calebe-sucupira/can-busoff-mitigation/experiments/busoff/plano_campanha_phase20_40_runs.csv

run_previsto | perfil | intervalo_min_us | intervalo_max_us | seed_hex | duracao_injecao_s | condicao | throttling_esperado | bloco | pulsos_ideais_previstos
304 | PHASE20 | 20000 | 20000 | 0x6D2B79F5 | 40 | ADAPTATIVO | 1 | 1 | 1999
305 | PHASE20 | 20000 | 20000 | 0x6D2B79F5 | 40 | ADAPTATIVO | 1 | 1 | 1999
306 | PHASE20 | 20000 | 20000 | 0x6D2B79F5 | 40 | ADAPTATIVO | 1 | 1 | 1999
307 | PHASE20 | 20000 | 20000 | 0x6D2B79F5 | 40 | ADAPTATIVO | 1 | 1 | 1999
308 | PHASE20 | 20000 | 20000 | 0x6D2B79F5 | 40 | ADAPTATIVO | 1 | 1 | 1999
309 | PHASE20 | 20000 | 20000 | 0x6D2B79F5 | 40 | REFERENCIA | 0 | 2 | 1999
310 | PHASE20 | 20000 | 20000 | 0x6D2B79F5 | 40 | REFERENCIA | 0 | 2 | 1999
311 | PHASE20 | 20000 | 20000 | 0x6D2B79F5 | 40 | REFERENCIA | 0 | 2 | 1999
312 | PHASE20 | 20000 | 20000 | 0x6D2B79F5 | 40 | REFERENCIA | 0 | 2 | 1999
313 | PHASE20 | 20000 | 20000 | 0x6D2B79F5 | 40 | REFERENCIA | 0 | 2 | 1999
314 | PHASE20 | 20000 | 20000 | 0x6D2B79F5 | 40 | ADAPTATIVO | 1 | 3 | 1999
315 | PHASE20 | 20000 | 20000 | 0x6D2B79F5 | 40 | ADAPTATIVO | 1 | 3 | 1999
316 | PHASE20 | 20000 | 20000 | 0x6D2B79F5 | 40 | ADAPTATIVO | 1 | 3 | 1999
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
