calebe-sucupira/can-busoff-mitigation/experiments/characterization/complementary/plano_24_ensaios.csv

run_previsto | bloco | condicao | throttling_esperado | perfil | intervalo_min_us | intervalo_max_us | seed_hex | duracao_injecao_s | pulsos_ideais_previstos | natureza
197 | 7 | REFERENCIA | 0 | BAIXO | 40000 | 60000 | 0xD820CD8A | 40 | 799 | AMPLIACAO_PREDEFINIDA_10_REPETICOES
198 | 7 | REFERENCIA | 0 | MEDIO_V2 | 17500 | 22500 | 0xD820CD8A | 40 | 2002 | AMPLIACAO_PREDEFINIDA_10_REPETICOES
199 | 7 | REFERENCIA | 0 | ALTO | 9375 | 14375 | 0xD820CD8A | 40 | 3376 | AMPLIACAO_PREDEFINIDA_10_REPETICOES
200 | 7 | ADAPTATIVO | 1 | ALTO | 9375 | 14375 | 0xD820CD8A | 40 | 3376 | AMPLIACAO_PREDEFINIDA_10_REPETICOES
201 | 7 | ADAPTATIVO | 1 | MEDIO_V2 | 17500 | 22500 | 0xD820CD8A | 40 | 2002 | AMPLIACAO_PREDEFINIDA_10_REPETICOES
202 | 7 | ADAPTATIVO | 1 | BAIXO | 40000 | 60000 | 0xD820CD8A | 40 | 799 | AMPLIACAO_PREDEFINIDA_10_REPETICOES
203 | 8 | ADAPTATIVO | 1 | MEDIO_V2 | 17500 | 22500 | 0x1E3D31CA | 40 | 2000 | AMPLIACAO_PREDEFINIDA_10_REPETICOES
204 | 8 | ADAPTATIVO | 1 | ALTO | 9375 | 14375 | 0x1E3D31CA | 40 | 3369 | AMPLIACAO_PREDEFINIDA_10_REPETICOES
205 | 8 | ADAPTATIVO | 1 | BAIXO | 40000 | 60000 | 0x1E3D31CA | 40 | 800 | AMPLIACAO_PREDEFINIDA_10_REPETICOES
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
