calebe-sucupira/can-busoff-mitigation/experiments/characterization/initial/plano_36_ensaios.csv

run_previsto | bloco | condicao | throttling_esperado | perfil | intervalo_min_us | intervalo_max_us | seed_hex | duracao_injecao_s | pulsos_ideais_previstos | natureza
153 | 1 | REFERENCIA | 0 | BAIXO | 40000 | 60000 | 0xEA125C50 | 40 | 804 | OFICIAL
154 | 1 | REFERENCIA | 0 | MEDIO_V2 | 17500 | 22500 | 0xEA125C50 | 40 | 1999 | OFICIAL
155 | 1 | REFERENCIA | 0 | ALTO | 9375 | 14375 | 0xEA125C50 | 40 | 3361 | OFICIAL
156 | 1 | ADAPTATIVO | 1 | ALTO | 9375 | 14375 | 0xEA125C50 | 40 | 3361 | OFICIAL
157 | 1 | ADAPTATIVO | 1 | MEDIO_V2 | 17500 | 22500 | 0xEA125C50 | 40 | 1999 | OFICIAL
158 | 1 | ADAPTATIVO | 1 | BAIXO | 40000 | 60000 | 0xEA125C50 | 40 | 804 | OFICIAL
159 | 2 | ADAPTATIVO | 1 | MEDIO_V2 | 17500 | 22500 | 0x361424B1 | 40 | 2004 | OFICIAL
160 | 2 | ADAPTATIVO | 1 | ALTO | 9375 | 14375 | 0x361424B1 | 40 | 3371 | OFICIAL
161 | 2 | ADAPTATIVO | 1 | BAIXO | 40000 | 60000 | 0x361424B1 | 40 | 800 | OFICIAL
162 | 2 | REFERENCIA | 0 | BAIXO | 40000 | 60000 | 0x361424B1 | 40 | 800 | OFICIAL
163 | 2 | REFERENCIA | 0 | ALTO | 9375 | 14375 | 0x361424B1 | 40 | 3371 | OFICIAL
164 | 2 | REFERENCIA | 0 | MEDIO_V2 | 17500 | 22500 | 0x361424B1 | 40 | 2004 | OFICIAL
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
