calebe-sucupira/can-busoff-mitigation/hardware/can-injector-board/can-injector-board.kicad_pcb

## KiCad design hardware/can-injector-board/can-injector-board.kicad_pcb (2026-10-07)

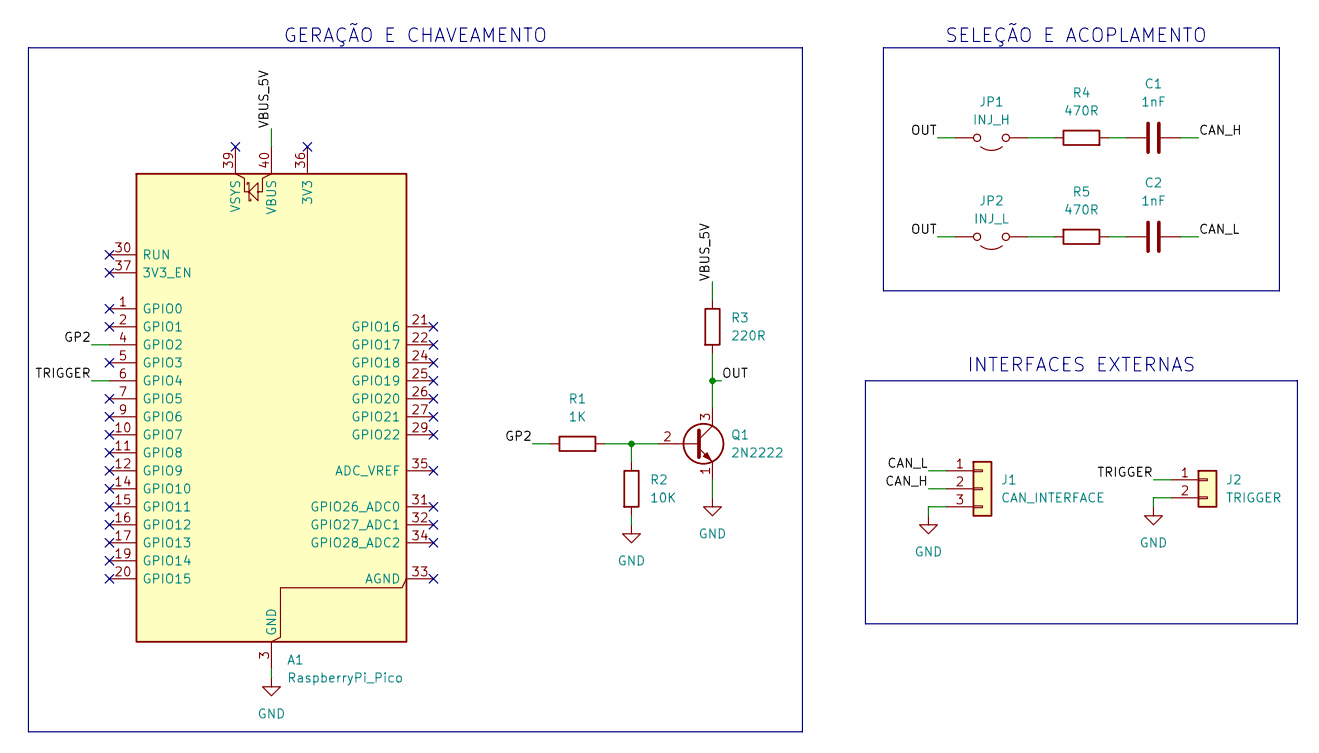
[picture p1: schematic can-injector-board.kicad_sch, CAN Perturbation Injector]

Parts:
A1: RaspberryPi_Pico; RaspberryPi_Pico_Common_THT_Manual
C1, C2: 1nF; C_Disc_D5.0mm_W2.5mm_P5.00mm_Manual
J1: CAN_INTERFACE; PinHeader_1x03_P2.54mm_Vertical_Manual
J2: TRIGGER; PinHeader_1x02_P2.54mm_Vertical_Manual
JP1: INJ_H; PinHeader_1x02_P2.54mm_Vertical_Manual
JP2: INJ_L; PinHeader_1x02_P2.54mm_Vertical_Manual
Q1: 2N2222; TO-92_Inline_Wide_Manual
R1: 1K; R_Axial_DIN0207_L6.3mm_D2.5mm_P7.62mm_Horizontal_Manual
R2: 10K; R_Axial_DIN0207_L6.3mm_D2.5mm_P7.62mm_Horizontal_Manual
R3: 220R; R_Axial_DIN0207_L6.3mm_D2.5mm_P7.62mm_Horizontal_Manual
R4, R5: 470R; R_Axial_DIN0207_L6.3mm_D2.5mm_P7.62mm_Horizontal_Manual

Connections:
/CAN_H: C1.2, J1.2
/CAN_L: C2.2, J1.1
/GP2: A1.4 (GPIO2), R1.1
/OUT: JP1.2 (B), JP2.2 (B), Q1.3 (C), R3.2
/TRIGGER: A1.6 (GPIO4), J2.1
/VBUS_5V: A1.40 (VBUS), R3.1
GND: A1.3 (GND), A1.8 (GND), A1.13 (GND), A1.18 (GND), A1.23 (GND), A1.28 (GND), A1.38 (GND), J1.3, J2.2, Q1.1 (E), R2.2
unnamed: C1.1, R4.2
unnamed: C2.1, R5.1
unnamed: JP1.1 (A), R4.1
unnamed: JP2.1 (A), R5.2
unnamed: Q1.2 (B), R1.2, R2.1

Notes on the sheet:
GERAÇÃO E CHAVEAMENTO
INTERFACES EXTERNAS
SELEÇÃO E ACOPLAMENTO

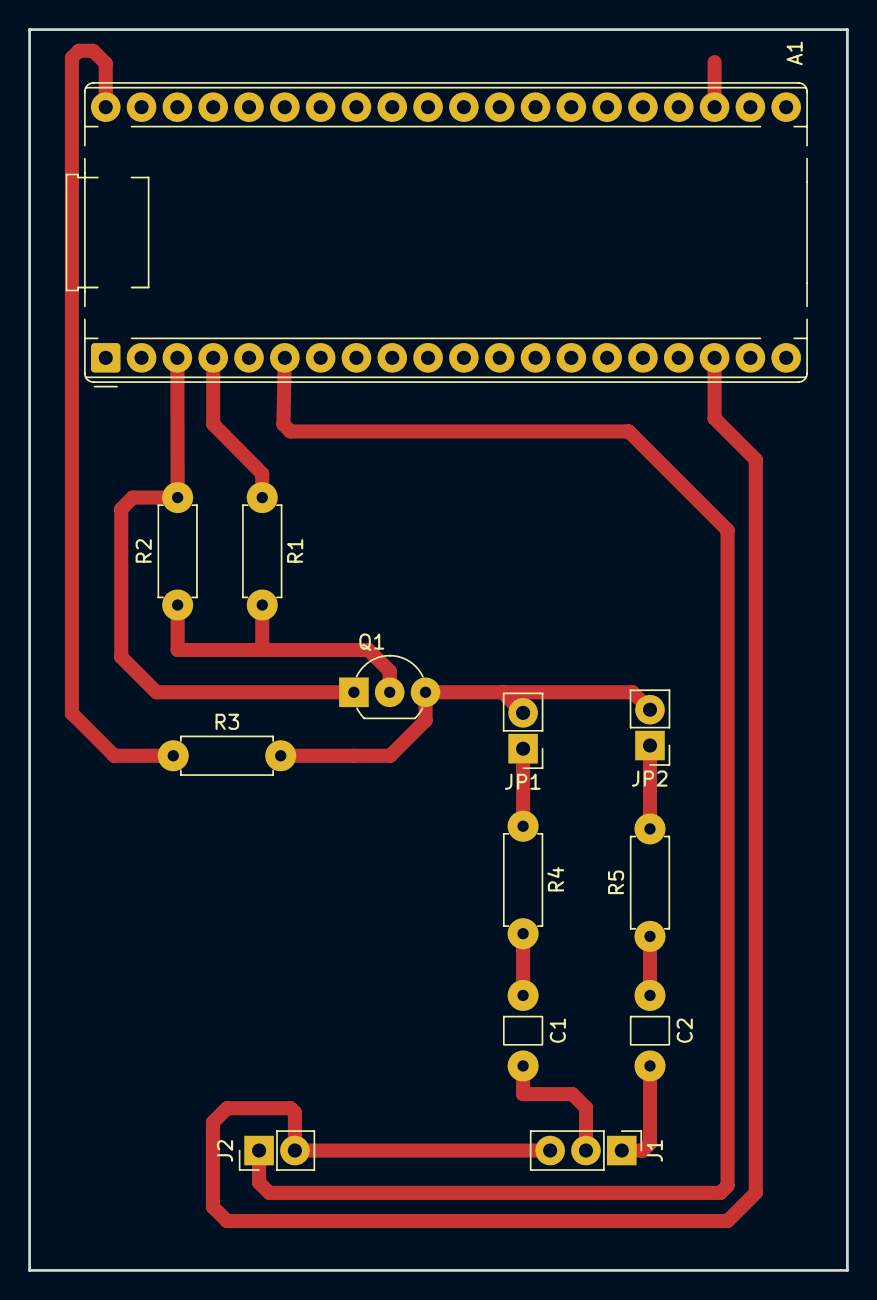
[picture p2: board can-injector-board.kicad_pcb from above]

Board: 2 copper layers, 58.0 x 88.0 mm, 13 parts (0 on the bottom side), 12 nets.
