calebe-sucupira/can-busoff-mitigation/hardware/can-experiment-board/can-experiment-board.kicad_pcb

## KiCad design hardware/can-experiment-board/can-experiment-board.kicad_pcb (2026-10-07)

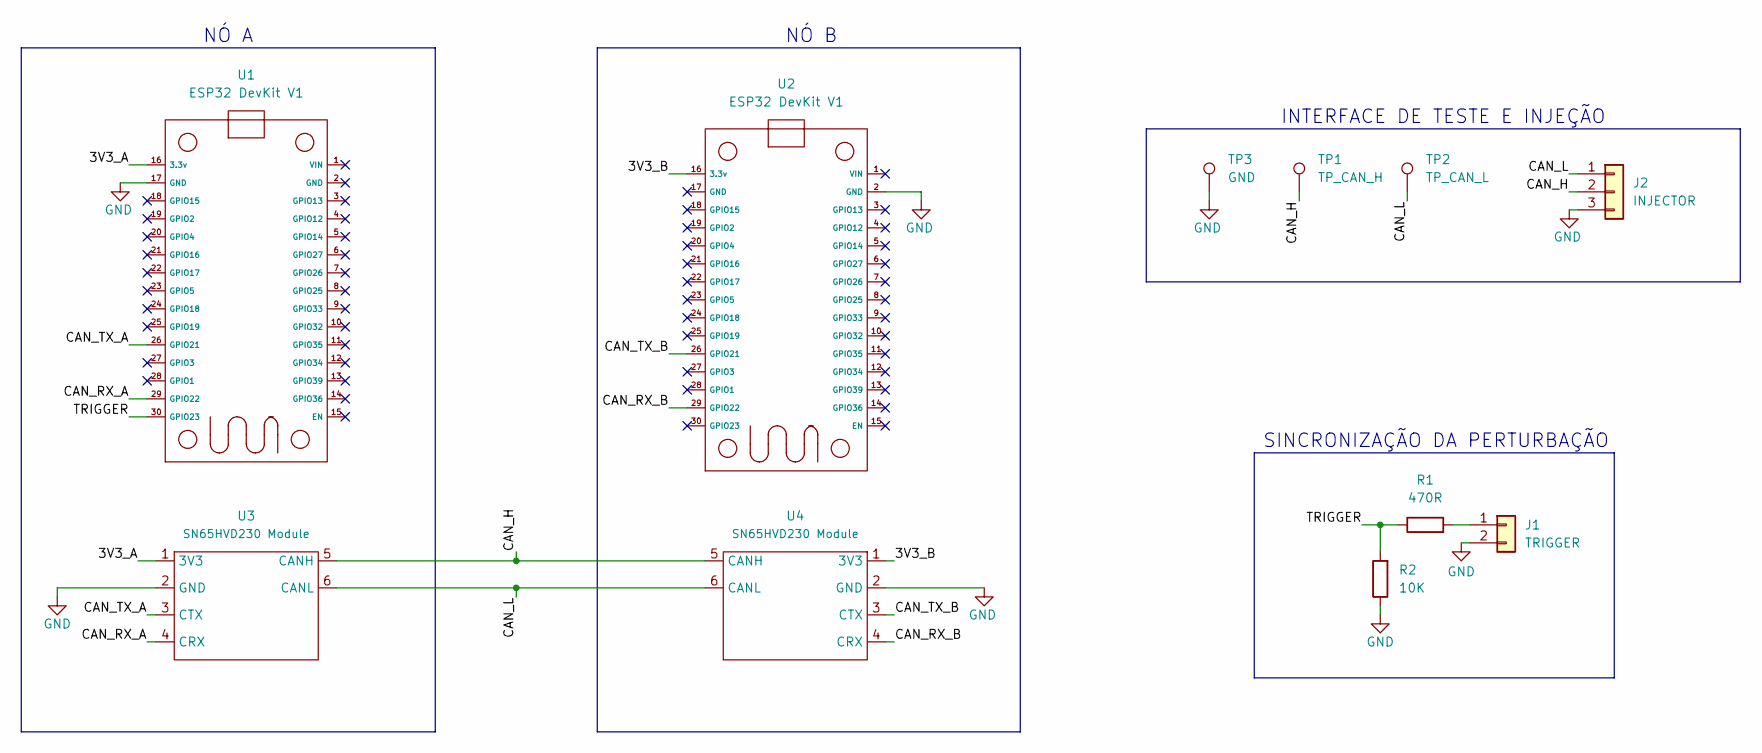
[picture p3: schematic can-experiment-board.kicad_sch, CAN Experiment Board]

Parts:
J1: TRIGGER; PinHeader_1x02_P2.54mm_Vertical_Manual
J2: INJECTOR; PinHeader_1x03_P2.54mm_Vertical_Manual
R1: 470R; R_Axial_DIN0207_L6.3mm_D2.5mm_P7.62mm_Horizontal_Manual
R2: 10K; R_Axial_DIN0207_L6.3mm_D2.5mm_P7.62mm_Horizontal_Manual
TP1: TP_CAN_H; TestPoint_THTPad_D2.5mm_Drill1.2mm
TP2: TP_CAN_L; TestPoint_THTPad_D2.5mm_Drill1.2mm
TP3: GND; TestPoint_THTPad_D2.5mm_Drill1.2mm
U1, U2: ESP32 DevKit V1; ESP32_30pin_Manual
U3, U4: SN65HVD230 Module; SN65HVD230_Module_1x06_Manual

Connections:
/3V3_A: U1.16 (3.3v), U3.1 (3V3)
/3V3_B: U2.16 (3.3v), U4.1 (3V3)
/CAN_H: J2.2, TP1.1 (1_1), U3.5 (CANH), U4.5 (CANH)
/CAN_L: J2.1, TP2.1 (1_1), U3.6 (CANL), U4.6 (CANL)
/CAN_RX_A: U1.29 (GPIO22), U3.4 (CRX)
/CAN_RX_B: U2.29 (GPIO22), U4.4 (CRX)
/CAN_TX_A: U1.26 (GPIO21), U3.3 (CTX)
/CAN_TX_B: U2.26 (GPIO21), U4.3 (CTX)
/TRIGGER: R1.1, R2.2, U1.30 (GPIO23)
GND: J1.2, J2.3, R2.1, TP3.1 (1_1), U1.17 (GND), U2.2 (GND), U3.2 (GND), U4.2 (GND)
unnamed: J1.1, R1.2

Notes on the sheet:
NÓ A
NÓ B
SINCRONIZAÇÃO DA PERTURBAÇÃO
INTERFACE DE TESTE E INJEÇÃO

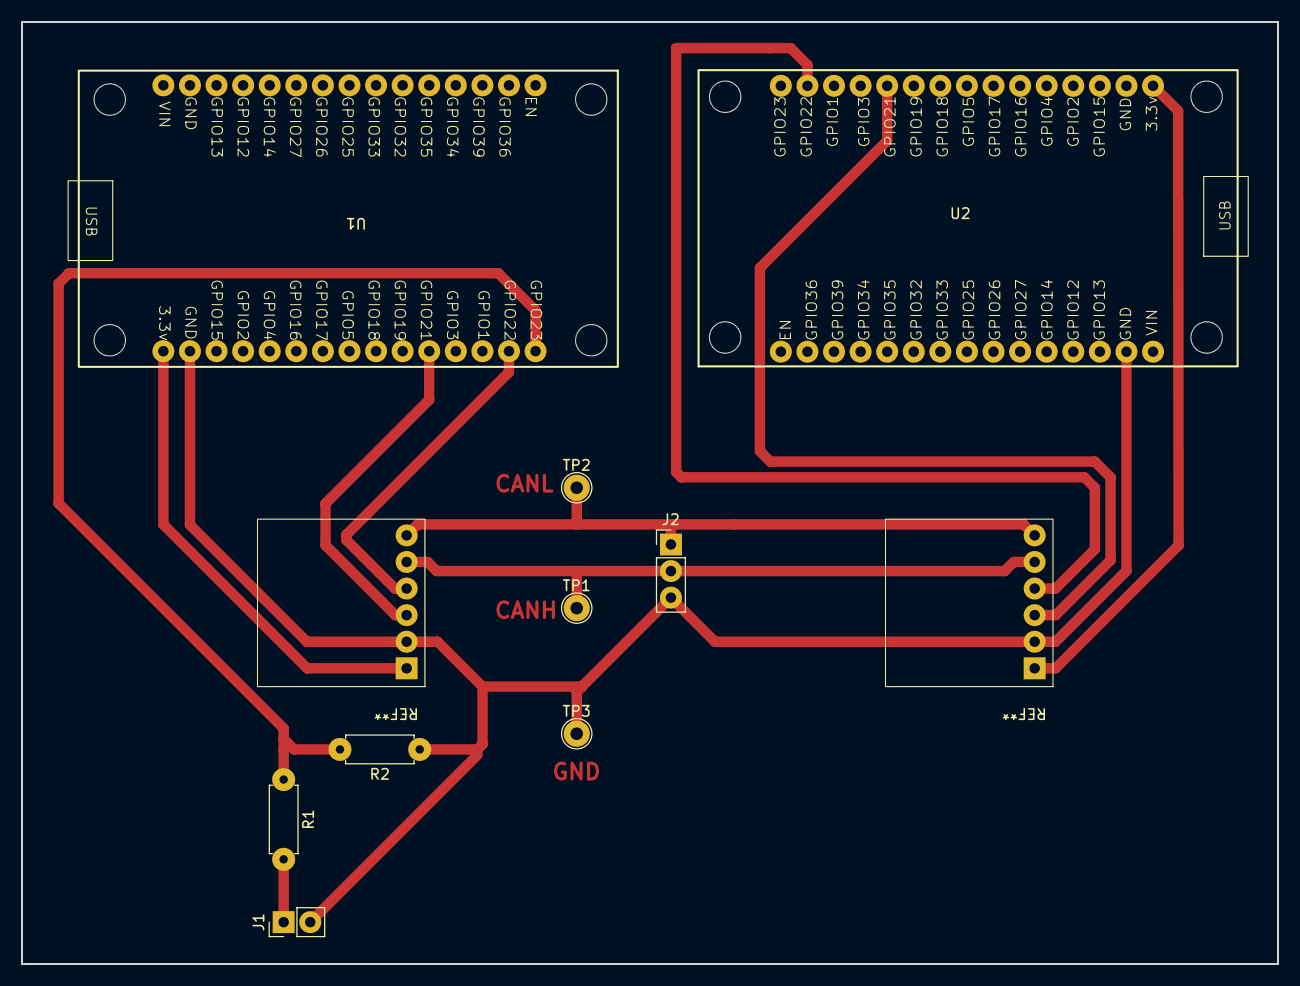
[picture p4: board can-experiment-board.kicad_pcb from above]

Board: 2 copper layers, 120.0 x 90.0 mm, 11 parts (0 on the bottom side), 11 nets.
