calebe-sucupira/can-busoff-mitigation/firmware/node-b/main/main.c

#include <stdbool.h>
#include <stdint.h>
#include <string.h>

#include "freertos/FreeRTOS.h"
#include "freertos/queue.h"
#include "freertos/task.h"

#include "esp_log.h"
#include "esp_timer.h"
#include "esp_twai.h"
#include "esp_twai_onchip.h"

#define TWAI_TX_GPIO       21
#define TWAI_RX_GPIO       22

#define CAN_BITRATE        125000
#define CAN_ID_UPDATE      0x100

#define MONITOR_PERIOD_MS      1
#define MONITOR_HEARTBEAT_MS 100

typedef struct {
    uint32_t sequence;
    uint32_t timestamp_ms;
} received_update_t;

typedef enum {
    EVENT_STATE_CHANGE,
    EVENT_ERROR
} event_type_t;

typedef struct {
    event_type_t type;
    uint64_t timestamp_us;

    union {
        struct {
            twai_error_state_t old_state;
            twai_error_state_t new_state;
        } state;

        struct {
            uint32_t flags;
        } error;
    };
} node_event_t;

static const char *TAG = "NODE_B";

static twai_node_handle_t twai_node = NULL;
static QueueHandle_t rx_queue = NULL;
static QueueHandle_t event_queue = NULL;

static const char *state_to_string(twai_error_state_t state)
{
    switch (state) {
        case TWAI_ERROR_ACTIVE:
            return "ACTIVE";

        case TWAI_ERROR_WARNING:
            return "WARNING";

        case TWAI_ERROR_PASSIVE:
            return "PASSIVE";

        case TWAI_ERROR_BUS_OFF:
            return "BUS_OFF";

        default:
            return "UNKNOWN";
    }
}

static bool rx_callback(
    twai_node_handle_t handle,
    const twai_rx_done_event_data_t *edata,
    void *user_ctx)
{
    uint8_t data[8];

    twai_frame_t frame = {
        .buffer = data,
        .buffer_len = sizeof(data),
    };

    if (twai_node_receive_from_isr(
            handle,
            &frame
        ) != ESP_OK) {

        return false;
    }

    if (frame.header.id != CAN_ID_UPDATE ||
        frame.header.dlc != 8) {

        return false;
    }

    received_update_t update;

    memcpy(
        &update.sequence,
        &data[0],
        sizeof(update.sequence)
    );

    memcpy(
        &update.timestamp_ms,
        &data[4],
        sizeof(update.timestamp_ms)
    );

    BaseType_t task_woken = pdFALSE;

    xQueueSendFromISR(
        rx_queue,
        &update,
        &task_woken
    );

    return task_woken == pdTRUE;
}

static bool state_change_callback(
    twai_node_handle_t handle,
    const twai_state_change_event_data_t *edata,
    void *user_ctx)
{
    node_event_t event = {
        .type = EVENT_STATE_CHANGE,
        .timestamp_us = esp_timer_get_time(),
    };

    event.state.old_state = edata->old_sta;
    event.state.new_state = edata->new_sta;

    BaseType_t task_woken = pdFALSE;

    xQueueSendFromISR(
        event_queue,
        &event,
        &task_woken
    );

    return task_woken == pdTRUE;
}

static bool error_callback(
    twai_node_handle_t handle,
    const twai_error_event_data_t *edata,
    void *user_ctx)
{
    node_event_t event = {
        .type = EVENT_ERROR,
        .timestamp_us = esp_timer_get_time(),
    };

    event.error.flags = edata->err_flags.val;

    BaseType_t task_woken = pdFALSE;

    xQueueSendFromISR(
        event_queue,
        &event,
        &task_woken
    );

    return task_woken == pdTRUE;
}

static void receiver_task(void *arg)
{
    received_update_t update;

    while (1) {
        if (xQueueReceive(
                rx_queue,
                &update,
                portMAX_DELAY
            ) != pdTRUE) {

            continue;
        }

        twai_node_status_t status;
        twai_node_record_t record;

        if (twai_node_get_info(
                twai_node,
                &status,
                &record
            ) == ESP_OK) {

            printf(
                "DATA,%llu,RECEIVED,%lu,%u,%u,%s,-,timestamp_ms=%lu\n",
                esp_timer_get_time(),
                (unsigned long)update.sequence,
                status.tx_error_count,
                status.rx_error_count,
                state_to_string(status.state),
                (unsigned long)update.timestamp_ms
            );
        }

        if ((update.sequence % 100) == 0) {
            ESP_LOGI(
                TAG,
                "RX seq=%lu timestamp=%lu ms",
                (unsigned long)update.sequence,
                (unsigned long)update.timestamp_ms
            );
        }
    }
}

static void monitor_task(void *arg)
{
    TickType_t last_wake_time = xTaskGetTickCount();

    bool initialized = false;

    uint32_t last_tec = 0;
    uint32_t last_rec = 0;
    uint32_t last_bus_errors = 0;

    twai_error_state_t last_state = TWAI_ERROR_ACTIVE;

    uint64_t last_log_us = 0;

    while (1) {
        twai_node_status_t status;
        twai_node_record_t record;

        if (twai_node_get_info(
                twai_node,
                &status,
                &record
            ) == ESP_OK) {

            uint64_t now_us = esp_timer_get_time();

            bool changed =
                !initialized ||
                status.tx_error_count != last_tec ||
                status.rx_error_count != last_rec ||
                status.state != last_state ||
                record.bus_err_num != last_bus_errors;

            bool heartbeat =
                initialized &&
                (now_us - last_log_us >=
                 MONITOR_HEARTBEAT_MS * 1000ULL);

            if (changed || heartbeat) {
                printf(
                    "DATA,%llu,SAMPLE,-1,%u,%u,%s,-,bus_errors=%lu\n",
                    now_us,
                    status.tx_error_count,
                    status.rx_error_count,
                    state_to_string(status.state),
                    (unsigned long)record.bus_err_num
                );

                last_log_us = now_us;
            }

            last_tec = status.tx_error_count;
            last_rec = status.rx_error_count;
            last_state = status.state;
            last_bus_errors = record.bus_err_num;

            initialized = true;
        }

        xTaskDelayUntil(
            &last_wake_time,
            pdMS_TO_TICKS(MONITOR_PERIOD_MS)
        );
    }
}

static void event_task(void *arg)
{
    node_event_t event;

    while (1) {
        if (xQueueReceive(
                event_queue,
                &event,
                portMAX_DELAY
            ) != pdTRUE) {

            continue;
        }

        twai_node_status_t status;
        twai_node_record_t record;

        if (twai_node_get_info(
                twai_node,
                &status,
                &record
            ) != ESP_OK) {

            continue;
        }

        switch (event.type) {
            case EVENT_STATE_CHANGE:
                printf(
                    "DATA,%llu,STATE_CHANGE,-1,%u,%u,%s,-,%s->%s\n",
                    event.timestamp_us,
                    status.tx_error_count,
                    status.rx_error_count,
                    state_to_string(status.state),
                    state_to_string(
                        event.state.old_state
                    ),
                    state_to_string(
                        event.state.new_state
                    )
                );
                break;

            case EVENT_ERROR:
                printf(
                    "DATA,%llu,ERROR,-1,%u,%u,%s,-,flags=0x%08lx\n",
                    event.timestamp_us,
                    status.tx_error_count,
                    status.rx_error_count,
                    state_to_string(status.state),
                    (unsigned long)event.error.flags
                );
                break;
        }
    }
}

void app_main(void)
{
    rx_queue = xQueueCreate(
        20,
        sizeof(received_update_t)
    );

    event_queue = xQueueCreate(
        64,
        sizeof(node_event_t)
    );

    ESP_ERROR_CHECK(
        rx_queue != NULL
            ? ESP_OK
            : ESP_ERR_NO_MEM
    );

    ESP_ERROR_CHECK(
        event_queue != NULL
            ? ESP_OK
            : ESP_ERR_NO_MEM
    );

    twai_onchip_node_config_t node_config = {
        .io_cfg = {
            .tx = TWAI_TX_GPIO,
            .rx = TWAI_RX_GPIO,
            .quanta_clk_out = -1,
            .bus_off_indicator = -1,
        },

        .bit_timing = {
            .bitrate = CAN_BITRATE,
        },

        .tx_queue_depth = 1,
    };

    ESP_ERROR_CHECK(
        twai_new_node_onchip(
            &node_config,
            &twai_node
        )
    );

    twai_event_callbacks_t callbacks = {
        .on_rx_done = rx_callback,
        .on_state_change = state_change_callback,
        .on_error = error_callback,
    };

    ESP_ERROR_CHECK(
        twai_node_register_event_callbacks(
            twai_node,
            &callbacks,
            NULL
        )
    );

    ESP_ERROR_CHECK(
        twai_node_enable(
            twai_node
        )
    );

    ESP_LOGI(
        TAG,
        "TWAI iniciado: %d bit/s",
        CAN_BITRATE
    );

    esp_log_level_set(
        "*",
        ESP_LOG_NONE
    );

    xTaskCreate(
        receiver_task,
        "receiver_task",
        4096,
        NULL,
        5,
        NULL
    );

    xTaskCreate(
        monitor_task,
        "monitor_task",
        4096,
        NULL,
        6,
        NULL
    );

    xTaskCreate(
        event_task,
        "event_task",
        4096,
        NULL,
        7,
        NULL
    );
}
