calebe-sucupira/can-busoff-mitigation/(commit log)

2026-08-21 Add initial project structure and Pico injector firmware
2026-08-21 Add CAN error monitoring to nodes
    [main.c]
2026-08-25 Add CAN experiment board schematic
    [can-experiment-board.kicad_pcb, can-experiment-board.kicad_sch]
2026-08-25 Ignore KiCad history files
2026-08-26 Complete CAN experiment board PCB layout
    [can-experiment-board.kicad_pcb, can-experiment-board.kicad_sch]
2026-08-26 Ignore KiCad history and lock files
2026-09-02 Add CAN injector board and unify trigger signal
    [can-experiment-board.kicad_pcb, can-experiment-board.kicad_sch, can-injector-board.kicad_pcb, can-injector-board.kicad_sch]
2026-09-14 feat: validate CAN baseline and data acquisition
    [can-experiment-board.kicad_pcb, can-experiment-board.kicad_sch, can-injector-board.kicad_pcb, can-injector-board.kicad_sch, node_a.csv, node_b.csv]
2026-10-07 checkpoint: bancada e injecao de falhas antes da calibracao gradual
    [can-experiment-board.kicad_pcb, can-injector-board.kicad_pcb]
2026-11-13 organiza repositório
    [PLANO_EXEMPLO_NAO_EXECUTAR_SEM_REVISAO.csv, agenda_nominal_phase20_40s.csv, cenarios_ilustrativos.csv, eventos_criticos.csv, evidencias_codigo.csv, indice.csv, inventario_fontes.csv, node_a.csv]
2026-11-13 remove arquivos desnecessários
    [comparacao_por_bloco_60.csv, comparacao_por_bloco_mesma_semente.csv, hashes_por_campanha.csv, hashes_por_run.csv, instantaneos_fontes.csv, intervalos_amostras_tec.csv, inventario_binarios.csv, janelas_tec_alto_com_erros.csv]
2026-11-13 limpa dados experimentais
    [node_a.csv, node_b.csv, pico.csv, plano_exploratorio_CAN_ALTO_runs_191_196.csv, plano_piloto_integrado_CAN_189_190.csv, plano_piloto_phase20.csv, plano_prevalidacao_CAN_runs_151_152.csv, plano_run303_adaptativo_phase20.csv]
2026-11-13 renomeia arquivos
    [plano_24_ensaios.csv, plano_36_ensaios.csv]
